ShadabMizan/ELEC291-Project2/Robot/Robot.ioc

Mcu.UserName=STM32L051K8Tx
PA0.Signal=S_TIM2_CH1
PA1.Signal=S_TIM2_CH2
PA10.Signal=USART1_RX
PA11.GPIO_Label=SONAR_BTN
PA11.Signal=GPXTI11
PA12.GPIO_Label=IR_TEST
PA12.Signal=GPXTI12
PA14.Signal=USART2_TX
PA15.Signal=USART2_RX
PA2.Signal=S_TIM2_CH3
PA3.Signal=S_TIM2_CH4
PA5.Signal=ADC_IN5
PA6.Signal=ADC_IN6
PA7.Signal=S_TIM22_CH2
PA8.GPIO_Label=STAT_LED
PA8.Signal=GPIO_Output
PA9.Signal=USART1_TX
PB1.Signal=ADC_IN9
PB4.Signal=S_TIM22_CH1
PB6.Signal=I2C1_SCL
PB7.Signal=I2C1_SDA
