ShadabMizan/ELEC291-Project2/(commit log)

2026-03-11 Initial Commit with initial STM32 for robot.
2026-03-13 Working Voltage Measurement Code.
2026-03-13 Added PWM Control.
2026-03-13 Added Interrupt detector.
2026-03-13 Added Time of Flight Driver. Untested.
2026-03-17 Supporting two byte IR and initial motor code.
2026-03-18 Working Motor Controller.
2026-03-26 Added the SPI Driver.
2026-03-27 Add collision detection and braking algorithm
    Implements a distance-based vehicle stop algorithm using the VL53L0X TOF sensor. The algorithm manages vehicle braking based on proximity to obstacles.
2026-03-27 Add collisionDetect.h for collision detection functionality
    This file contains definitions and prototypes for collision detection and distance-based stopping.
2026-03-29 4V 18.2kHz WORKING CODE FOR AUTOMODE.
2026-03-29 added servo shit
